szelenin/toygun/images/IMG_6874.jpg

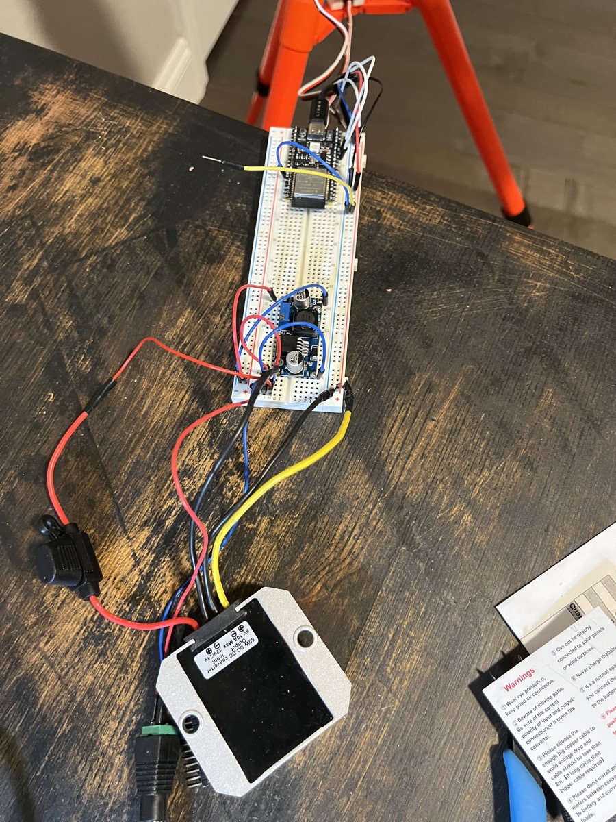
images/IMG_6874.jpg
