szelenin/toygun/images/IMG_6875.jpg

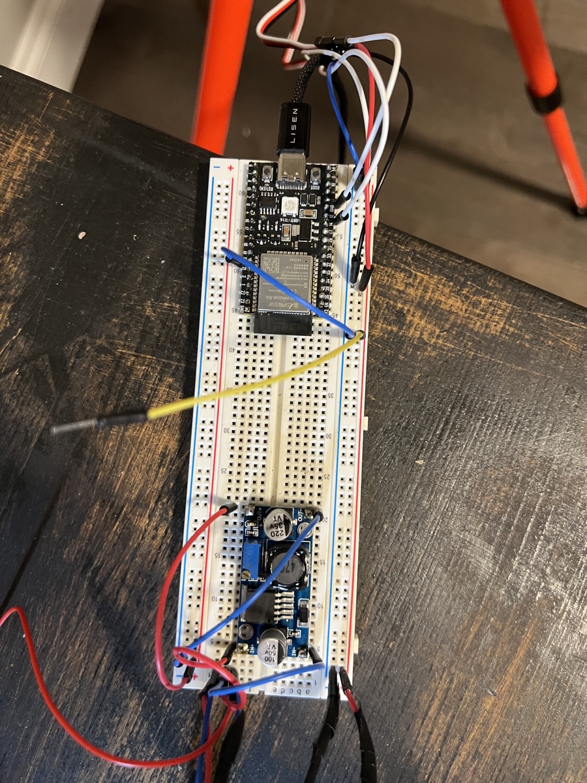
images/IMG_6875.jpg
