szelenin/toygun/images/IMG_6877.jpg

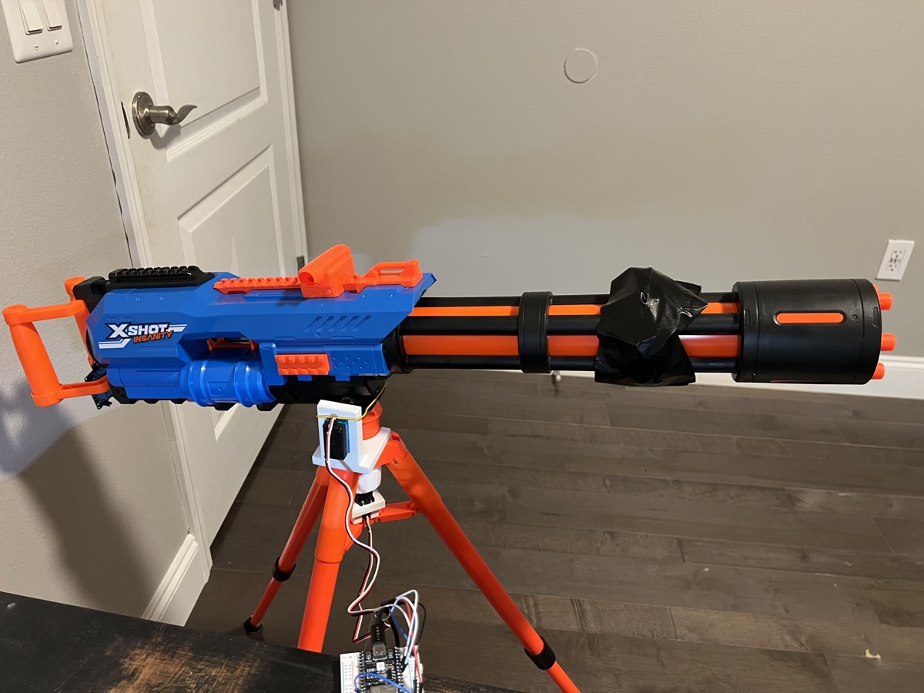
images/IMG_6877.jpg
