szelenin/toygun/images/IMG_6878.jpg

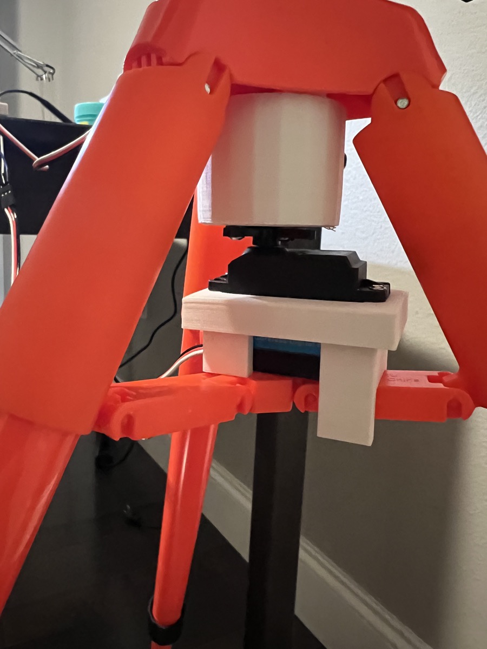
images/IMG_6878.jpg
