szelenin/toygun/images/IMG_6879.jpg

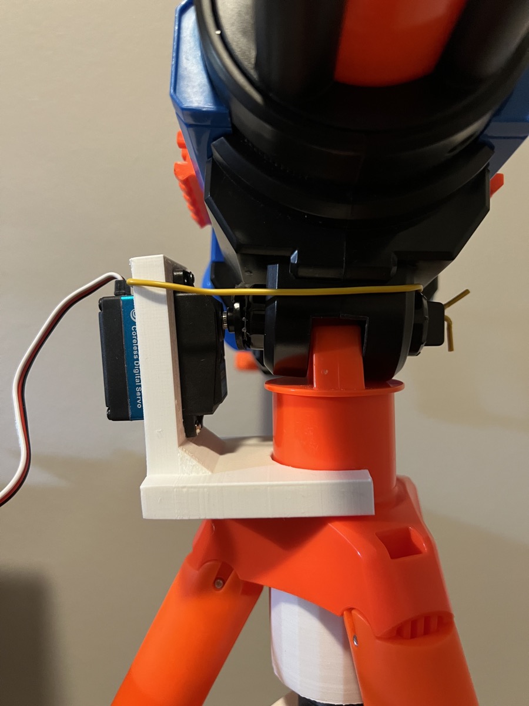
images/IMG_6879.jpg
