szelenin/toygun/images/IMG_6880.jpg

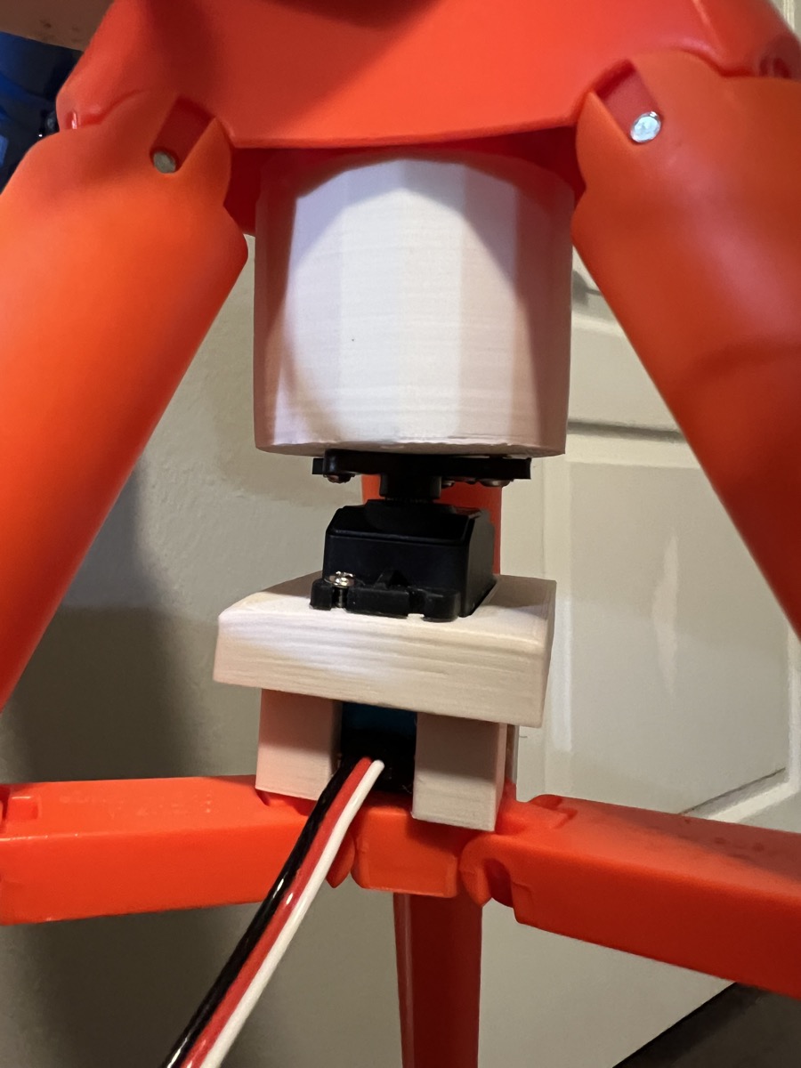
images/IMG_6880.jpg
