szelenin/toygun/(commit log)

2025-11-11 Initial commit: Step 1 - Basic servo control at 90 degrees
    - Added project README with hardware components and power architecture
    - Created ToyGunControl Arduino sketch for ESP32
    - Implemented dual servo control (GPIO 12, 13)
    - Set initial position to 80 degrees for both servos
    - Added project images
2025-11-12 Step 3a: Add WiFi webserver with static IP and mDNS
    Features:
    - WiFi connection with configurable credentials
    - Static IP configuration (192.168.86.42)
    - mDNS support (access via http://toygun.local)
    - Basic web interface showing servo positions
    - UTF-8 charset for proper emoji display
    Updated:
    - Added WiFi, WebServer, and mDNS libraries
    - Configured static IP with gateway, subnet, and DNS
    - Created HTML interface with status display
    - Removed auto-sweep movement (servos hold position)
    - Added comprehensive WiFi setup documentation to README
    Hardware:
    - GPIO 12: Horizontal servo
    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
2025-11-12 Step 3b+c: Add directional control UI with keydown/keyup events
    - Beautiful gradient UI with 4 directional buttons (up/down/left/right)
    - Press and hold to move, release to stop
    - Real-time position updates every 200ms
    - Visual button press feedback
    - Mobile-friendly touch support
    Implementation:
    - Added movement control booleans (movingUp, movingDown, etc.)
    - API endpoints: /move (start/stop) and /position (JSON status)
    - Smooth servo movement: 1° per 20ms
    - JavaScript handles mouse and touch events
    - Position polling updates display
    Hardware control:
    - Vertical servo: GPIO 13 (75° to 105° range)
    - Horizontal servo: GPIO 12 (0° to 180° range)
    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
2025-11-12 Improve UI sync: Reduce position polling interval to 50ms
    Changed position update interval from 200ms to 50ms for better
    synchronization between displayed values and actual servo movement.
    Before: UI updated 5 times/sec (numbers jumped by ~10°)
    After: UI updates 20 times/sec (numbers jump by ~2-3°)
    This provides much smoother visual feedback while maintaining
    reasonable network traffic (20 requests/sec vs 5 requests/sec).
2025-11-12 Step 3d: Add position persistence with auto-save
    - Load saved positions from flash on startup (or default to 90° if never saved)
    - Auto-save positions 3 seconds after movement stops
    - Positions survive power cycles and restarts
    - Uses ESP32 Preferences library for NVS storage
    - Minimal flash wear (saves only when idle after movement)
    - Added Preferences library for non-volatile storage
    - loadPositions(): Reads hAngle and vAngle from flash on boot
    - savePositions(): Writes current positions to flash
    - Auto-save logic: Tracks lastActivityTime, saves after 3 sec idle
    - Position tracking: positionChanged and positionsSaved flags
    Flash endurance:
    - Saves only on butto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
2025-11-12 Fix servo direction and slow down movement speed
    Changes:
    - Reversed vertical servo direction (up button now moves correctly)
    - Slowed movement from 20ms to 30ms delay (33 degrees/sec instead of 50)
    Before:
    - Up button increased angle (wrong direction)
    - Down button decreased angle
    - Speed: 1° per 20ms = 50°/second
    After:
    - Up button decreases angle (correct direction)
    - Down button increases angle
    - Speed: 1° per 30ms = 33°/second (smoother, more controlled)
2025-11-12 Add reset button to clear saved positions and return to center
    - Reset button in web UI (pink gradient, below controls)
    - Clears all saved positions from flash memory
    - Resets both servos to 90° (center position)
    - Confirmation dialog before reset
    - Success/failure alerts
    - New /reset API endpoint
    - handleReset() function:
    - Clears preferences from flash
    - Sets horizontalAngle and verticalAngle to 90°
    - Moves servos to center position
    - Resets positionsSaved flags
    - JavaScript confirmation and feedback
    - Serial output confirms reset action
    Use case:
    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
2025-11-12 Restrict vertical lower limit to 100° and slow movement to 40ms
    - Vertical max limited to 100° (down from 105°)
    - Movement delay increased to 40ms (down from 30ms)
    - Vertical range: 75° to 105°
    - Speed: 1° per 30ms = 33°/second
    - Vertical range: 75° to 100° (more restricted)
    - Speed: 1° per 40ms = 25°/second (20% slower)
    Vertical servo now moves more slowly and has tighter range
    for better control and safety.
    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
2025-11-12 Add assembly photos and documentation
    Added 6 photos showing the complete turret assembly:
    Electronics:
    - IMG_6874.jpg: Breadboard with ESP32 and buck converters
    - IMG_6875.jpg: Close-up of control electronics
    Servo Mounting:
    - IMG_6878.jpg: Vertical servo mount on tripod
    - IMG_6879.jpg: Horizontal rotation mechanism
    - IMG_6880.jpg: Dual-servo mounting detail
    Complete Assembly:
    - IMG_6877.jpg: Fully assembled turret on tripod
    Updated README with new "Assembly Photos" section showcasing:
    - Breadboard setup with power regulation
    - 3D printed servo mounting system
    - Complete turret assembly
    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
2025-11-12 Optimize assembly photos - reduce file sizes
    Resized all assembly images to 1200px max dimension for faster loading.
    - IMG_6874.jpg: 1.8MB → 414KB (77% smaller)
    - IMG_6875.jpg: 2.5MB → 402KB (84% smaller)
    - IMG_6877.jpg: 1.8MB → 192KB (89% smaller)
    - IMG_6878.jpg: 1.7MB → 149KB (91% smaller)
    - IMG_6879.jpg: 1.5MB → 141KB (91% smaller)
    - IMG_6880.jpg: 1.0MB → 152KB (85% smaller)
    Total: 10.3MB → 1.5MB (85% reduction)
    Images maintain quality while loading much faster for README viewers.
    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
2025-11-18 Add relay module wiring diagrams with annotations
    - Created annotated wiring diagrams for 2-channel relay module
    - Control pins diagram showing VCC, GND, IN1 (GPIO 14), IN2 (GPIO 15)
    - Output terminals diagram showing COM/NO/NC for both relays
    - Added comprehensive Relay Module Wiring section to README
    - Detailed wiring instructions for spinner and trigger motors
    - Visual guide with arrows and color-coded labels
    Documentation:
    - Relay 1: Controls spinner motor (GPIO 14)
    - Relay 2: Controls trigger motor (GPIO 15)
    - Includes safety warnings about motor ground connections
    - Updated hostname to "lizardgun3000"
    Images created with Python/Pillow and saved to images/ folder
    🤖 Gener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
2025-11-22 Remove incorrect relay wiring diagrams
    Removed relay module wiring section and annotated images as they were not correct.
2025-11-22 Step 4a: Add 2-relay control for firing mechanism
    - Added relay control for spinner and trigger motors
    - GPIO 14: Trigger motor (Relay 1)
    - GPIO 15: Spinner motor (Relay 2)
    - Active-LOW relay logic (HIGH = OFF, LOW = ON)
    - API endpoint: /relay with query parameters
    - Control via: /relay?spinner=on, /relay?trigger=off
    - Returns JSON with current relay states
    - Relay pin definitions and state variables
    - Pin initialization in setup() (both OFF by default)
    - handleRelay() function for control
    - Serial debug output for relay state changes
    - Relays powered by 5V buck converter
    - Common ground with ESP32
    - Ready for Step 4b UI integration
    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
2025-11-22 Step 4b: Add shoot button with automatic firing sequence
    - Large prominent "SHOOT" button in web UI (red gradient)
    - Automatic firing sequence implementation
    - Visual feedback during firing (button shows "Firing...")
    - Button auto-disables to prevent multiple clicks
    Firing Sequence:
    1. Spinner motor ON (flywheels spin up)
    2. Delay 250ms (reach full speed)
    3. Trigger motor ON (feed dart into flywheels)
    4. Delay 100ms (dart fires)
    5. Trigger motor OFF
    6. Spinner motor OFF
    Total: ~350ms complete sequence
    - handleShoot() function with timed sequence
    - /shoot API endpoint
    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
2025-11-28 Add CONTEXT.md - Project status and session summary
    Created comprehensive context document including:
    - Current status: Step 4c complete (press-and-hold trigger)
    - Hardware configuration and GPIO assignments
    - Power system architecture
    - Network settings (192.168.86.42, lizardgun3000.local)
    - Known issue: Inconsistent dart firing (needs trigger pulsing)
    - Complete todo list and remaining steps
    - All technical details and code references
    - Next session action items
    This document ensures continuity when migrating to new Claude version.
2025-12-06 Add ESP32-CAM wiring diagram to README
    Added comprehensive wiring documentation for ESP32-CAM migration:
    Schematic Diagram:
    - Full ASCII art system diagram showing all connections
    - Power distribution (12V → 6V/5V buck converters)
    - ESP32-CAM to servo/relay connections
    - Common ground topology
    Pin Mapping Table:
    - GPIO 12: Horizontal Servo
    - GPIO 13: Vertical Servo
    - GPIO 14: Trigger Relay
    - GPIO 15: Spinner Relay
    Additional Content:
    - ESP32-CAM pinout diagram (top view)
    - Wire color guide
    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
2025-12-06 Add ESP32-CAM to hardware components list
    Added Aideepen ESP32-CAM with OV2640 Camera + MB Programmer Board
    Amazon link: B0948ZFTQZ (2-pack)
2025-12-08 Add ESP32-WROOM-32E hardware reference documentation
    Added new section with:
    - ESP32-WROOM-32E programming guide image
    - Board schematic image showing CH340K USB-TTL, power, GPIO headers
    - Key pins reference table (TXD0, RXD0, EN, IO0, power pins)
    - Instructions for using ESP32-WROOM as USB-Serial programmer for ESP32-CAM
    Images from manufacturer documentation for future reference.
2025-12-08 Improve ESP32-WROOM as USB-Serial programmer documentation
    Updated wiring diagram with:
    - GPIO numbers for TXD0 (GPIO 1) and RXD0 (GPIO 3)
    - Three-column diagram showing WROOM, CAM, and power source
    - Complete connection summary table with all 7 wires
    - Post-upload instructions for disconnecting IO0
2025-12-08 Move Hardware Reference Documentation to end of README
    Reorganized README structure - moved ESP32-WROOM-32E documentation
    section to the end for better readability and easier reference.
2025-12-13 Simplify ESP32-CAM wiring diagram
    - Remove confusing schematic diagram
    - Remove wire color guide
    - Update ESP32-CAM pinout to show servo and relay connections clearly
2025-12-13 Replace ASCII pinout with Mermaid diagram
    - Use GitHub-supported Mermaid flowchart for better rendering
    - Shows ESP32-CAM connections to servos, relays, and power
2025-12-13 Step 6: Add camera streaming to control UI
    - Integrate ESP32-CAM camera with MJPEG streaming on port 81
    - Add live video feed with crosshair overlay to web UI
    - AI Thinker ESP32-CAM pin definitions included
    - Stream runs on separate server (port 81) to avoid blocking controls
    - Compact UI layout with video above controls
2025-12-13 Add flash LED control to UI
    - Add light toggle button to web interface
    - LED on GPIO 4 can be turned on/off for night vision
    - Button changes color when LED is active
2025-12-13 Add admin panel for camera tuning
    - New /admin page with camera settings
    - Live RSSI signal strength display (color-coded)
    - Live FPS counter (color-coded)
    - Resolution selector (QVGA to UXGA)
    - JPEG quality slider (10-63)
    - Apply settings button
    - Link to admin from main control page
2025-12-13 Add persistent storage for camera settings
    - Save framesize and quality to flash when changed
    - Load saved settings on boot (defaults: VGA, quality 12)
    - Settings survive reboots
2025-12-14 Add memory monitoring and auto-apply settings
    - Display free heap memory in admin panel
    - Display free PSRAM in admin panel
    - Color-coded memory stats (green/yellow/red)
    - Auto-apply settings on change (no Apply button needed)
    - Debounced quality slider to avoid spam
    - Settings still save to flash automatically
2025-12-14 Add chip temperature monitoring to admin panel
    - Display ESP32 internal temperature in Celsius
    - Color-coded: green (<60°C), yellow (60-75°C), red (>75°C)
    - Helps diagnose thermal throttling issues
2025-12-14 Add frame timing diagnostics to admin panel
    Shows capture time, send time, and average frame size (KB) to help
    identify whether streaming bottleneck is camera capture or network.
    Stats are calculated as rolling averages over 10 frames.
2025-12-14 Fix temperature reading and add PSRAM status indicator
    - temperatureRead() returns Celsius, not Fahrenheit - removed incorrect conversion
    - Added PSRAM detection status to admin panel (shows "Detected" or "NOT FOUND")
    - Helps diagnose why camera may default to QVGA when PSRAM unavailable
2025-12-14 Fix LED causing WiFi interference - use PWM brightness control
    The flash LED at full power draws too much current, causing voltage drops
    that destabilize WiFi transmission. Changed from digital on/off to PWM:
    - Added brightness slider (0-255) in control UI
    - Default "on" now uses 25% brightness (64/255)
    - Shows tip to keep below 50% to avoid interference
    - PWM uses channel 2 at 5kHz to avoid camera conflicts
2025-12-14 Update YouTube link for relay wiring guide in README
2025-12-14 Replace assembly photos with YouTube demo video
2025-12-14 Fix LEDC API for newer ESP32 Arduino core
    Updated from deprecated ledcSetup/ledcAttachPin to new ledcAttach API.
    New API uses pin directly instead of channel for ledcWrite.
2025-12-15 Optimize streaming performance for no-PSRAM mode
    - Disable WiFi power saving (WiFi.setSleep(false)) to reduce latency
    - Use single frame buffer when no PSRAM (saves memory, reduces complexity)
    - Increase default JPEG compression for no-PSRAM mode (quality 20)
    - Always grab latest frame to avoid stale buffer issues
2025-12-15 Fix LED slider flooding requests - only send on release
    Changed from debounced 'input' events to 'change' event which only
    fires when slider is released. Prevents request flooding that was
    blocking the single-threaded WebServer.
2025-12-15 Migrate to non-blocking esp_http_server for controls
    Major performance improvement - replaced blocking Arduino WebServer
    with ESP-IDF esp_http_server for the control endpoints:
    - Control server (port 80) now runs on Core 0
    - Stream server (port 81) runs separately
    - Both servers are fully non-blocking/async
    - Removed server.handleClient() from loop - no longer needed
    - Controls should now be responsive even during streaming lag
2025-12-15 Fix httpd control socket conflict between servers
    Each httpd instance needs a unique ctrl_port (internal control socket).
    Set stream server ctrl_port to 32769 (default is 32768) to avoid conflict
    with control server.
2025-12-15 Add debug output for camera config changes
    Shows result code and actual value after set_framesize/set_quality
    to diagnose why settings may be reverting.
2025-12-15 Add more debug output to config handler
    Print full query string and whether params are found to diagnose
    why settings aren't being saved.
2026-01-08 Update README with ESP32-CAM-MB wiring diagram
    - Added complete wiring diagram for ESP32-CAM-MB programmer board
    - Included 1N5819 Schottky diode for power protection
    - Explained backfeeding prevention with diode on barrel power
    - Added programming instructions for ESP32-CAM-MB
    - Link to Amazon product B0CQVB6JFV
2026-01-08 Fix README: Update wiring for FT232RL FTDI adapter
    Corrected product link B0CQVB6JFV - it's an FT232RL FTDI USB-C to TTL
    adapter, not ESP32-CAM-MB. Updated wiring diagrams with:
    - FTDI TX → ESP32-CAM U0R
    - FTDI RX → ESP32-CAM U0T
    - IO0 → GND for programming mode
    - Set FTDI jumper to 3.3V
    - Power ESP32-CAM from 5V buck, not FTDI
2026-01-08 Add FTDI adapter to Electronics & Power section
2026-01-08 Add IO0 programming mode switch to wiring diagrams
    Updated diagrams to show SPST switch between IO0 and GND for
    toggling programming mode instead of jumper wire.
2026-01-14 Update README to use DROK Mini buck converters
    - Replace LM2596/YRDZXG with DROK Mini as primary converters
    - Keep old converters as alternatives in components list
    - Update all wiring diagrams to show DROK Mini @ 6V (servos) and @ 5.3V (ESP32)
    - Add FTDI VCC to common 5V rail for dual power source support
    - Update diode protection section with DROK references
2026-01-18 Add perfboard connector pinout documentation
    10-pin header layout for servos and relay module:
    - Pins 1-3: Horizontal Servo (IO12, 6V, GND)
    - Pins 4-6: Vertical Servo (IO13, 6V, GND)
    - Pins 7-10: Relay Module (GND, IO15, IO14, 5V)
2026-01-18 Fix perfboard pinout view - top of board (camera view)
    Pins numbered right to left when viewing from top/camera side.
2026-01-18 Fix perfboard pinout - Pin 1 on left, view from top
2026-04-20 Switch to DHCP and fix relay docs
    - Remove static IP in favor of DHCP to avoid IP conflicts; use lizardgun3000.local instead
    - Fix README relay mapping: Relay 1 = Trigger (GPIO 14), Relay 2 = Spinner (GPIO 15)
    - Remove core_id=0 from control server httpd config
    - Add error logging for httpd start failures
    - Add WiFi event logging, heap monitoring, and loop heartbeat for diagnostics
2026-09-05 Fix broken component links in README
    Replace the three placeholder blogger.com edit URLs with real AliExpress
    listings for the servos and relay module. The AMG8833 IR camera listing is
    gone, so it points at an AliExpress search instead.
    Claude-Session: https://claude.ai/code/session_01SnHGeMd1NgXfmqymsBtq6J
2026-09-05 Add BLE turret firmware on a second ESP32, split docs per board
    The turret now runs two boards, one job each. The ESP32-CAM keeps its existing
    firmware for the camera and web UI; a new ESP32-WROOM-32E takes servos and
    firing relays over Bluetooth LE, so a Flipper Zero can drive it with no WiFi and
    no add-on hardware on either side.
    The perfboard header uses the same GPIO numbers on both boards, so it plugs into
    either one — but only one at a time, or two push-pull outputs fight over the
    servo signal line.
    ToyGunTurretBLE:
    - NimBLE peripheral exposing the Nordic UART service, so it can be driven from
    nRF Connect before any Flipper app exists
    - Deadman watchdog: any disconnect, or 1500 m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
    [ToyGunCamWiFi.ino, ToyGunTurretBLE.ino]
2026-09-05 Invert BLE roles: turret is the central, Flipper the peripheral
    The Flipper cannot act as a BLE central. Checked against the official
    targets/f7/api_symbols.csv: no exported symbol for scanning, connecting
    outward, or GATT client operations. The previous design had both ends as
    peripherals, which can never connect.
    So the WROOM scans and connects, and talks over the Flipper's built-in Serial
    profile — which IS exported to apps as a plain byte pipe:
    + ble_profile_serial (template)
    + ble_profile_serial_tx
    + ble_profile_serial_set_event_callback
    + ble_profile_serial_set_rpc_active
    - ble_profile_hid (not exported, hence not HID)
    This works on stoc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
    [ToyGunTurretBLE.ino]
2026-09-05 Bench-test the turret firmware on hardware, fix two rough edges
    Flashed to the WROOM and exercised over USB serial. Working: boot, restoring
    saved angles from NVS, BLE scanning, the V handshake, movement at 25 deg/sec,
    position persistence, and the deadman watchdog cutting movement after 1500 ms
    of silence. Firing is still untested — the relays have not been switched.
    Two things testing surfaced:
    - Position was reported every 200 ms until the flash save three seconds later,
    so a stationary turret resent the same POS about fifteen times. Now it reports
    only when the angle actually changed.
    - A busy room produces ~30 unnamed advertisers per scan sweep, which buried the
    one line that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
    [ToyGunTurretBLE.ino]
2026-09-05 Get the turret talking to the Flipper: paired, bonded, subscribed
    End to end on hardware: scan, match by MAC, connect, pair with a passkey, bond,
    discover the Serial service, subscribe to it. Reconnects silently afterwards.
    Pairing OK, link encrypted
    TX props: read=1 notify=0 indicate=1 | RX props: write=1 wnr=1
    Link up. Waiting for commands.
    -> VER 1 LizardGun3000
    Four things had to be fixed, all now documented in PROTOCOL.md:
    - The TX characteristic is CHAR_PROP_READ | CHAR_PROP_INDICATE. It indicates, it
    never notifies, and NimBLE's subscribe() takes "notifications" as its first
    argument — so indications need subscribe(false, cb). This was the actual bug;
    it presented a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
    [ToyGunTurretBLE.ino]
2026-09-05 Verify PROTOCOL.md against the real Flipper, correct the MTU claim
    Dumped the full GATT database off the actual device rather than trusting the
    firmware source, and reconciled every claim in the document against it.
    Confirmed on hardware: the service UUID, all four characteristic UUIDs, and
    their exact properties. TX really is indicate-only (i=1, n=0) and RX really does
    accept write-without-response, so the earlier fixes were addressing the real
    shape of the service and not a coincidence.
    Corrected: the document said MTU 64, which was our requested value rather than
    the negotiated one. Measured ATT MTU is 255. Immaterial for a protocol whose
    longest message is about twenty bytes, but a wro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
2026-09-05 Add the Flipper Zero remote app
    A starter app with the Bluetooth plumbing already correct, so the interesting
    part — how it looks and feels — is what's left to write. Arrows aim, OK fires,
    and the turret's replies show on screen.
    Builds clean against Flipper SDK 1.4.3, API 87.1, target 7. It has been
    compiled but never run.
    The app is the peripheral and does not scan or connect: it opens the Flipper's
    Serial profile and writes text into it, and the turret — the central — is
    already listening.
    Two things it gets right that are easy to get wrong, both commented at the top
    of the source and repeated in the README:
    - ble_profile_serial_set_rpc_active(profile, false), without which th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
2026-09-05 Recast the Flipper app as reference material, not the app to use
    The son has started writing his own remote, so this folder should be something
    he can raid rather than something he has to adopt.
    Split the Bluetooth out of the example into turret_link.c/h — two files that
    drop into any Flipper app and reduce talking to the turret to three calls:
    alloc, hold, tick. It knows nothing about screens or buttons, so it does not
    impose a design on whoever uses it.
    toygun_remote.c is now only screen and buttons, small enough to read in one
    sitting, and reads as a worked example of using turret_link rather than as
    the finished article.
    The README leads with "this is a reference, not the app you ha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
2026-09-07 Add docs/flipper-marauder.md: flashing a spare WROOM as a Flipper WiFi board
    Side project, separate from the turret. Wires the second WROOM to the Flipper
    GPIO and runs WiFi Marauder on it. Records the wiring, the build that actually
    works, and a copy-paste esptool procedure so re-flashing later is trivial.
    Key gotcha captured: the "flipper" Marauder build is ESP32-S2 (the official
    Flipper WiFi Devboard is an S2), so it boot-loops on a plain ESP32-WROOM. The
    "old_hardware" build (chip_id 0000) is the right one, and esptool's "not an
    ESP32 image" warning means chip mismatch — not something to --force past.
    Flashed and verified on the second WROOM (44:1d:64:f8:2b:5c); the turret's WROOM
    wa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
2026-09-07 Correct flipper-marauder doc: flash via Flipper "Other ESP32-WROOM"
    The doc told you to esptool-flash the old_hardware release from the Mac, which
    is exactly what produced an empty scan list. old_hardware boots and answers
    commands but drives an external-antenna pin a bare WROOM lacks, so it hears
    nothing.
    The path that actually works, verified on hardware: flash from the Flipper via
    [ESP] Flasher -> Quick Flash -> Other ESP32-WROOM -> Marauder, entering the
    bootloader by hand (hold BOOT, tap EN, release BOOT) because the Flipper cannot
    reset a bare WROOM over 4 wires. Scan then List -> ap returns real networks.
    Kept the Mac/esptool route as advanced, with the chip-id check and a warning
    n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
